GigiaaaChen/ECE496/Bi-Weekly Meeting Agenda/2026-03-11.md

# Meeting Title: [HeadsUp's Meeting with Professor Rose]

**Date:** 2026-03-11
**Time:** 17:00 - 18:00 [EST]
**Location:** [Engineering Annex Room 319]

**Regrets:**
* [No Regrets]

**Meeting Purpose:**
[To go over development progress.]

---

## Agenda Items
1.  **[Technical Update——remote controller related]** (Time Allotted: [5 min])
    *   **Discussion Points:**
        *   Polished and ordered PCB board, waiting to receive
        *   Next step: test pcb with esp32 board plugged in, all periperals connected
        *   
    *   **Presenter/Lead:** [Caroline]

2.  **[Technical Update - Robotic arm move along with user's head]** (Time Alloted: [10 min])
   
   *   **Discussion Points:**
        *   In Person Demo.
        *   <https://drive.google.com/file/d/19JhtsvQpiPmR6sTPJtSpPem1BOKgM7OM/view?usp=drive_link>
        
   *   **Presenter/Lead:** [Georgia & Kyna]

3.  **[Round of Table]** (Time Alloted: [10 min])
    *   **Discussion Points:**
        *   Everyone is free to raise concerns if any.
    *   **Presenter/Lead:** [All]

---
<!--
## Action Items

*   **[Action Item 1 Description]**
    *   **Assigned To:** [Name]
    *   **Due Date:** YYYY-MM-DD

*   **[Action Item 2 Description]**
    *   **Assigned To:** [Name]
    *   **Due Date:** YYYY-MM-DD

---
-->

## Wrap-up

<!--
*   **Future Agenda Items/Parking Lot:**
    *   [Item 1 for future discussion]
    *   [Item 2 for future discussion]
-->
