GigiaaaChen/ECE496/Bi-Weekly Meeting Agenda/2026-02-24.md

# Meeting Title: [HeadsUp's Meeting with Professor Rose]

**Date:** 2026-02-24
**Time:** 14:00 - 15:00 [EST]
**Location:** [Engineering Annex Room 319]

**Regrets:**
* [No Regrets]

**Meeting Purpose:**
[To go over development progress.]

---

## Agenda Items
1.  **[Technical Update——remote controller related]** (Time Allotted: [5~10 min])
    *   **Discussion Points:**
        *   learning and designing PCB
        *   Completed the first version of PCB board. 
        
         

    *   **Presenter/Lead:** [Caroline]

2.  **[Technical Update - Robotic arm move along with user's head]** (Time Alloted: [10 min])
   <https://drive.google.com/file/d/192zWKHXX6un7FPb0EQjLP_sl4fwDq9Ix/view?usp=drive_link>
    *   **Presenter/Lead:** [Georgia & Kyna]

3.  **[Round of Table]** (Time Alloted: [10 min])
    *   **Discussion Points:**
        *   Everyone is free to raise concerns if any.
    *   **Presenter/Lead:** [All]

---
<!--
## Action Items

*   **[Action Item 1 Description]**
    *   **Assigned To:** [Name]
    *   **Due Date:** YYYY-MM-DD

*   **[Action Item 2 Description]**
    *   **Assigned To:** [Name]
    *   **Due Date:** YYYY-MM-DD

---
-->

## Wrap-up

*   **Next Meeting Date & Time:** 2026-03-10
<!--
*   **Future Agenda Items/Parking Lot:**
    *   [Item 1 for future discussion]
    *   [Item 2 for future discussion]
-->
