GigiaaaChen/ECE496/Bi-Weekly Meeting Agenda/2026-01-27.md

# Meeting Title: [HeadsUp's Meeting with Professor Rose]

**Date:** 2026-01-27
**Time:** 14:00 - 15:00 [EST]
**Location:** [Engineering Annex Room 319]

**Zoom Link for slide sharing** <https://utoronto.zoom.us/j/89166823159> (Passcode: 371175)

**Regrets:**
* [No Regrets]

**Meeting Purpose:**
[To go over development progress and oral presentation feedback.]

---

## Agenda Items
1.  **[Technical Update——remote controller related]** (Time Allotted: [5 min])
    *   **Discussion Points:**
        *   learning and designing PCB
        *   Completed the system-level schematic for the ESP32-based controller, including power decoupling, EN and boot configuration, and a UART debug interface for programming and debugging.
        *   Defined the interfaces for the touchpad and IMU peripherals. Both devices share an I²C bus, with additional reset and ready control signals allocated for the touchpad. GPIO assignments are now fixed.
        
    *   **Presenter/Lead:** [Caroline]

2.  **[Oral Presentation feedback]** (Time Alloted: [30 min])
   <https://docs.google.com/presentation/d/1UrTfd9N_lOdqF6I55duHeB9kDg2tpaxMmB8UQcs0UWE/edit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>
    *   **Presenter/Lead:** [All]

4.  **[Round of Table]** (Time Alloted: [10 min])
    *   **Discussion Points:**
        *   Everyone is free to raise concerns if any.
    *   **Presenter/Lead:** [All]

---
<!--
## Action Items

*   **[Action Item 1 Description]**
    *   **Assigned To:** [Name]
    *   **Due Date:** YYYY-MM-DD

*   **[Action Item 2 Description]**
    *   **Assigned To:** [Name]
    *   **Due Date:** YYYY-MM-DD

---
-->

## Wrap-up

*   **Next Meeting Date & Time:** 2026-01-26
<!--
*   **Future Agenda Items/Parking Lot:**
    *   [Item 1 for future discussion]
    *   [Item 2 for future discussion]
-->
