GigiaaaChen/ECE496/Bi-Weekly Meeting Agenda/2026-01-13.md

# Meeting Title: [HeadsUp's Meeting with Professor Rose]

**Date:** 2026-01-13
**Time:** 14:00 - 15:00 [EST]
**Location:** [Engineering Annex Room 319]

**Regrets:**
* [No Regrets]

**Meeting Purpose:**
[To go over development progress and set future paths.]

---

## Agenda Items
0.  **[Quick Recap]** (Time Allotted: [3~5 min])
    *   **Discussion Points:**
        *   Project Overview
    *   **Presenter/Lead:** [All]

1.  **[Technical Update——Software related]** (Time Allotted: [20 min])
    *   **Discussion Points:**
        * Wrapper that runs head‐pose and distance estimation on the RDK board
          *  Demo video <https://drive.google.com/file/d/1lOdTqtMvCCk78k4vAbRYOeW9VvrZjbeK/view?usp=drive_link>
        * Robotic arm adjusting forward/backward based on distance between camera and user's eyes
          * Target distance between user's eye and the camera: 30cm
          * Live Demo
    *   **Presenter/Lead:** [Kyna, Georgia]
  
2.  **[Technical Update——Remote controller]** (Time Allotted: [10 min])
    *   **Discussion Points:**
        *   Intergrated gyrascope module
        *   Able to interpret wrist movement as BACK/FORWARD/RIGHT/LEFT command
        *   Demo video: <https://drive.google.com/file/d/1Lf4ZTEof56o803nbZ39Lbo83GLm88Rxz/view?usp=sharing>
        *   Next step: design pcb to connect all modules together
    *   **Presenter/Lead:** [Caroline]

3.  **[Round of Table]** (Time Alloted: [10 min])
    *   **Discussion Points:**
        *   Everyone is free to raise concerns if any.
    *   **Presenter/Lead:** [All]

---
<!--
## Action Items

*   **[Action Item 1 Description]**
    *   **Assigned To:** [Name]
    *   **Due Date:** YYYY-MM-DD

*   **[Action Item 2 Description]**
    *   **Assigned To:** [Name]
    *   **Due Date:** YYYY-MM-DD

---
-->

## Wrap-up

*   **Next Meeting Date & Time:** 2026-01-26
<!--
*   **Future Agenda Items/Parking Lot:**
    *   [Item 1 for future discussion]
    *   [Item 2 for future discussion]
-->
