GigiaaaChen/ECE496/Bi-Weekly Meeting Agenda/2025-11-19.md

# Meeting Title: [HeadsUp's Meeting with Professor Rose]

**Date:** 2025-11-19
**Time:** 13:00 - 14:00 [EST]
**Location:** [Engineering Annex Room 319]

**Regrets:**
* [No Regrets]

**Meeting Purpose:**
[To go over development progress and set future paths.]

---

## Agenda Items
0.  **[Quick Recap]** (Time Allotted: [3~5 min])
    *   **Discussion Points:**
        *   Last meeting's progress
    *   **Presenter/Lead:** [All]

1.  **[Robotic Arm Status Update]** (Time Allotted: [15 min])
    *   **Discussion Points:**
        *   User safety program: [10 min]
            *   change the spd and acc paramter in .ino file for slower movement.
        *   Next Steps & Questions: [5 min]
            *   inside loop() there's a serialCtrl() to consecutively read .json command (use \n as termination of each json command)
            *   convert movement to .json and send it throught serial port. 
    *   **Presenter/Lead:** [Xindi]

2.  **[Remote Controller]** (Time Allotted: [15 min])
    *   **Discussion Points:**
        *   Current Phone <--> Controller status: [5 min]
            *   Can control mouse and click on the phone
            *   Demo: <https://drive.google.com/file/d/1lfOFU0sGAoy6dm8gPM5qx5ULZvsO4gEU/view?usp=sharing>
        *   Current Controller <--> RDK board status: [5 min]
            *   Setting up a SD card to be the RDK X5 board's OS disk
            *   Exploring the option of connecting to the board with ssh over ethernet
            *   Exploring the option of making the RDk a WiFi hotspot and let the ESP connect to it.
        * Next Steps & Questions: [5 min]
            *   Plans to implement controller <--> RDK (robotic arm manual control component)

    *   **Presenter/Lead:** [Caroline, Kyna]

3.  **[AI Development]** (Time Allotted: [10 min])
    *   **Discussion Points:**
        *   Distance calculation current status: [5 min]
        *   Next Steps & Questions: [5 min]
    *   **Presenter/Lead:** [Georgia]

4.  **[Round of Table]** (Time Alloted: [5 min])
    *   **Discussion Points:**
        *   Everyone is free to raise concerns if any.
    *   **Presenter/Lead:** [All]

---
<!--
## Action Items

*   **[Action Item 1 Description]**
    *   **Assigned To:** [Name]
    *   **Due Date:** YYYY-MM-DD

*   **[Action Item 2 Description]**
    *   **Assigned To:** [Name]
    *   **Due Date:** YYYY-MM-DD

---
-->

## Wrap-up

*   **Next Meeting Date & Time:** 2025-12-03 at 13:00 [EST]
<!--
*   **Future Agenda Items/Parking Lot:**
    *   [Item 1 for future discussion]
    *   [Item 2 for future discussion]
-->
