GigiaaaChen/ECE496/Bi-Weekly Meeting Agenda/2025-11-05.md

# Meeting Title: [HeadsUp's Meeting with Professor Rose]

**Date:** 2025-11-05
**Time:** 13:00 - 14:00 [EST]
**Location:** [Engineering Annex Room 319]

**Regrets:**
* [No Regrets]

**Meeting Purpose:**
[To go over Implementation plan and design progress.]

---

## Agenda Items
0.  **[Quick Recap]** (Time Allotted: [5 min])
    *   **Discussion Points:**
        *   Progress at last meeting:
              - Software side: capture head presence
              - Hardware side: Successfully used the ESP32 as a Bluetooth keyboard to type “A” on a mobile device.
    *   **Presenter/Lead:** [All]

1.  **[Robotic Arm Status Update]** (Time Allotted: [10 min])
    *   **Discussion Points:**
        *   Short demo
    *   **Presenter/Lead:** [Kyna]

2.  **[Remote Controller]** (Time Allotted: [15 min])
    *   **Discussion Points:**
        *   Touchpad choice
            *   ‎TPS43-201A-S‎
            *   datasheet: <https://mm.digikey.com/Volume0/opasdata/d220001/medias/docus/2228/TPS43%2C_TPS65_Datasheet_Web.pdf>

        *   Connection test
            *   Initially had connection stability issue (I2C device detection rate ~50%); -> debug for some time -> physical connection issue
            *   Successfully tested the touchpad functionality: a. touch detection b. finger movement
            *   Code: 3 test files under </Code/touchpad/>
            *   Demo: <https://drive.google.com/file/d/1IlfUudXawYgz8bIy3xPxCfUHl7lm8f1n/view?usp=sharing>
                      <https://drive.google.com/file/d/191tMU3OSIy8Gl-pjyDWnSANHjQ12yvUU/view?usp=sharing>

    *   **Presenter/Lead:** [Caroline, Kyna]

4.  **[Implementation plan]** (Time Alloted: [10 min])

    *   **Discussion Points:**
        *   Alternatives <https://docs.google.com/document/d/1LDAkIZtnCHnaRkNVZI81DXIajryKaZFpqkIAGWt7qSE/edit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>
        *   Technical Design and Implementation
        *   Verification method <https://docs.google.com/document/d/1sx3VLkyrA7urFOH0zRqTkTGyVxNIEc0N3eo4rawDgiI/edit?tab=t.0>
    *   **Presenter/Lead:** [All]

---
<!--
## Action Items

*   **[Action Item 1 Description]**
    *   **Assigned To:** [Name]
    *   **Due Date:** YYYY-MM-DD

*   **[Action Item 2 Description]**
    *   **Assigned To:** [Name]
    *   **Due Date:** YYYY-MM-DD

---
-->

## Wrap-up

*   **Next Meeting Date & Time:** 2025-10-22 at 13:00 [EST]
<!--
*   **Future Agenda Items/Parking Lot:**
    *   [Item 1 for future discussion]
    *   [Item 2 for future discussion]
-->
