GigiaaaChen/ECE496/Bi-Weekly Meeting Agenda/2025-09-24.md

# Meeting Title: [HeadsUp's Meeting with Professor Rose]

**Date:** 2025-09-24
**Time:** 13:00 - 14:00 [EST]
**Location:** [Engineering Annex Room 319]

**Regrets:**
* [No Regrets]

**Meeting Purpose:**
[To go over and refine our project scope, discuss on initial steps of implementation,
and have a clear timeline.]

---

## Agenda Items

1.  **[Scope Refinement]** (Time Allotted: [10 min])
    *   **Discussion Points:**
        *   The team has agreed to purchase the robotic arm.
        *   Project requirements (maybe objectives and constraints)
        *   <https://docs.google.com/document/d/1KIvG_XDotNgLkBPigFyyJez73JBbbRWh3T6C6AaLDVs/edit?usp=sharing>
    *   **Presenter/Lead:** [All]

2.  **[Robotic Arm]** (Time Allotted: [15 min])
    *   **Discussion Points:**
        *   Product description of the robotic arm our team decides to purchase
            5-DOF: <https://www.waveshare.net/shop/RoArm-M3-Pro-AI-Kit.htm>
            4-DOF: <https://www.waveshare.net/shop/RoArm-M2-Pro.htm>
        *   Full integration feasability
    *   **Presenter/Lead:** [Kyna]

3.  **[Remote Controller]** (Time Allotted: [15 min])
    *   **Discussion Points:**
        *   Feasability and first steps of remote controller development based on the 
            components we have.
            <https://docs.google.com/document/d/1xD3LGZtlMNOlYi2HF-REvZS8fy5g-5u1e_dpQWy6dVo/edit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>
        *    ↑ This document includes: Physical component choice & Planned steps of implementation
    *   **Presenter/Lead:** [Caroline]

4.  **[Next Step and Plan]** (Time Alloted: [10 min])
    *   **Discussion Points:**
        *   Task division and next development deadline
        *   Timeline discussion
    *   **Presenter/Lead:** [All]

---
<!--
## Action Items

*   **[Action Item 1 Description]**
    *   **Assigned To:** [Name]
    *   **Due Date:** YYYY-MM-DD

*   **[Action Item 2 Description]**
    *   **Assigned To:** [Name]
    *   **Due Date:** YYYY-MM-DD

---
-->

## Wrap-up

*   **Next Meeting Date & Time:** 2025-10-08 at 13:00 [EST]
<!--
*   **Future Agenda Items/Parking Lot:**
    *   [Item 1 for future discussion]
    *   [Item 2 for future discussion]
-->
