GigiaaaChen/ECE496/Reports/ECE496_Team2025143_Project Snapshot.pdf

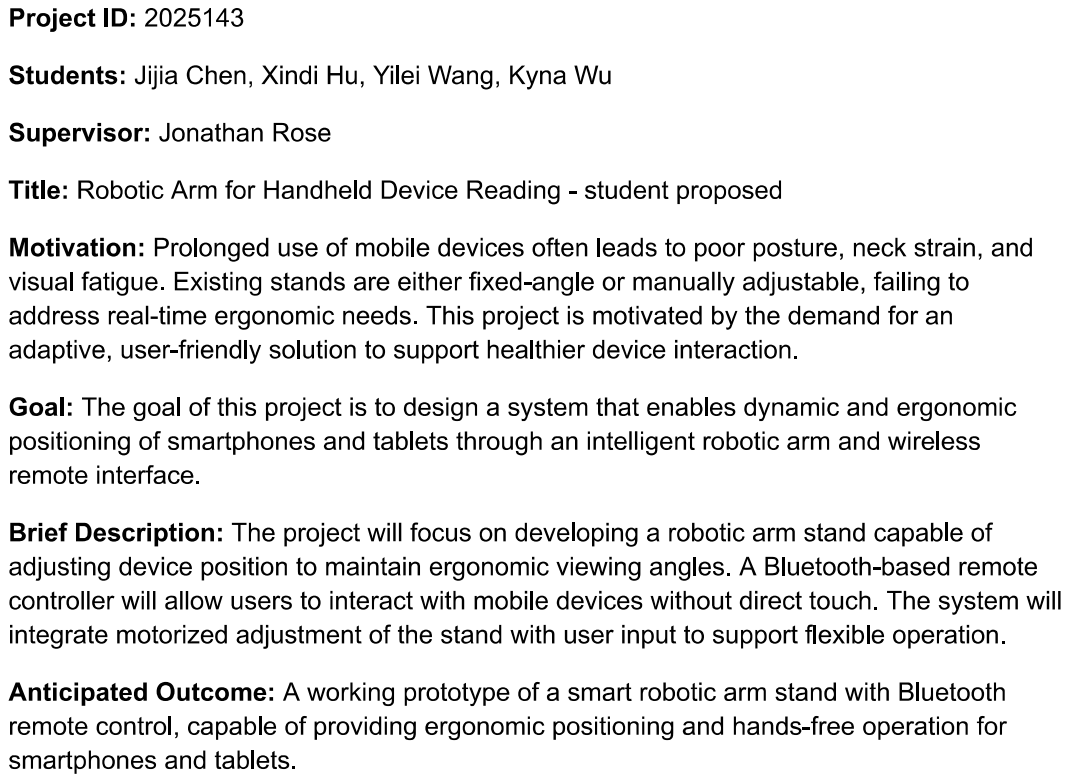
[picture p4: page 1]
