GigiaaaChen/ECE496/Bi-Weekly Meeting Agenda/images/system block diagram.jpg

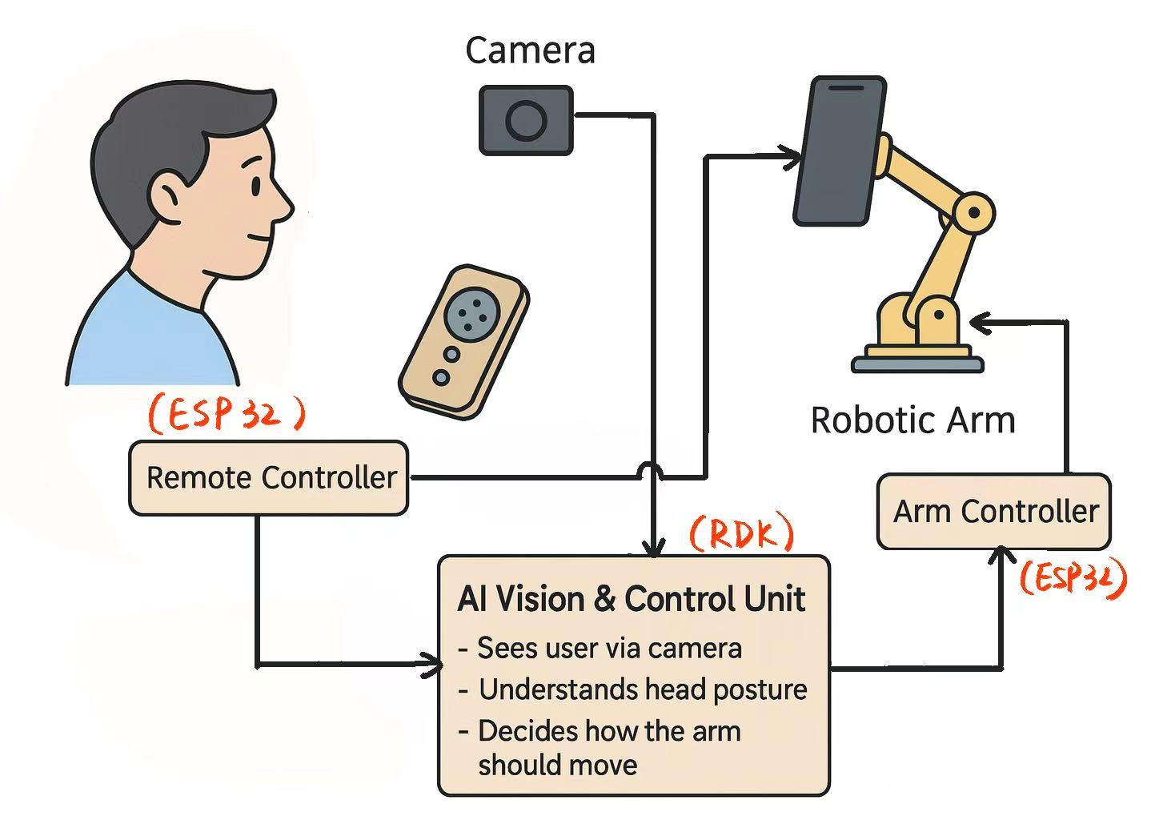
Bi-Weekly Meeting Agenda/images/system block diagram.jpg
