GigiaaaChen/ECE496/Bi-Weekly Meeting Agenda/images/winter_deliverables.png

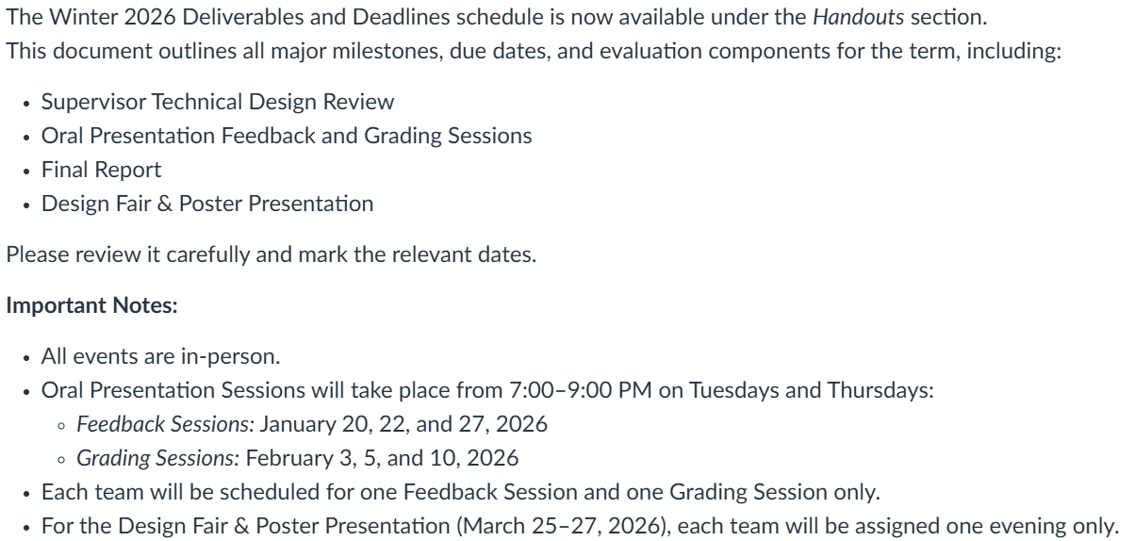
Bi-Weekly Meeting Agenda/images/winter_deliverables.png
