GigiaaaChen/ECE496/(commit log)

2025-10-05 ESP32 first bluetooth connection test
2025-11-04 Implement I2C device scanning functionality
    This code scans for I2C devices and tracks the presence of device 0x74, reporting statistics on each scan.
2025-11-05 Add touch LED off test code
2025-11-05 Add scan_xy_coord.ino for IQS5xx sensor
    Initial implementation of XY coordinate scanning for IQS5xx sensor.
2025-11-05 Create scan_I2C_connection.ino for I2C scanning
    Add a new file for scanning I2C connections.
2025-11-05 Add comment for recording finger xy coordinates
    Added a comment to indicate the purpose of the code.
2025-11-18 上下左右和灵敏度还需要调，但可以让cursor出现在手机上了，同时可以typeA，且碰到触控板会亮起LED灯
2025-11-18 修了一点灵敏度&上下相反的问题，但鼠标还是有点飘忽
    Increased sensitivity divisor for mouse movement.
    [type+mouse.ino]
2025-11-18 鼠标还是有点飘忽需要微调，增加了click和不太成功的关机
2025-11-19 增加comment
2025-11-21 可以发送信息到RDK上
2026-03-10 added laptop to arm code and ai models.
2026-03-18 有command（left right foward backward
2026-03-20 touchpad+5秒重连+button1 detected
2026-03-20 button1+button2.下一步是integrate IMU进来 用button1做切换。
2026-03-20 integrated。只差button2的lock和unlock
2026-03-20 Refactor button2 functionality and improve comments
2026-03-24 灵敏度较低，还需调整；实现了双指上下左右scrolling
    Updated button pin assignments and adjusted touchpad sensitivity parameters. Enhanced touchpad handling logic for better stability and responsiveness.
    [0_Caroline_final.ino]
2026-03-24 scrolling不太好 但基本还行 在做微调
2026-03-24 scrolling还行 但是cursor还是有点太灵敏
    Added touchStartTime to manage touch duration and adjust movement sensitivity based on touch age.
2026-03-24 在ipad上相对不错的版本
2026-03-25 Add initial implementation of I2C backup for ESP32
2026-03-25 tracking稍微对了点；user和manual还要调
2026-03-25 Create simulator
    simulator for the robotic arm
